tysecgh/woodreel/README.txt

木製スピニングリールの設計図のプロジェクト

designote.pdf
概要をまとめたテキスト

PARTS.pdf
部品ごとの平面図

scadfフォルダ以下
OpenScadによって記述したパラメトリック3Dモデル
それから生成した平面図(SVG)や可搬3Dモデル(STL)等

Licenses
- All files (including *.pdf, *.scad, *.tex, *.svg, *.stl): CC BY 4.0
  https://creativecommons.org/licenses/by/4.0/
Copyright (c) 2026 tysecgh
