tysecgh/woodreel/designote.pdf

# 木製スピニングリールの構造概要設計

平成 38 年 10 月 30 日

## 1 リール全体構造と部位 ID

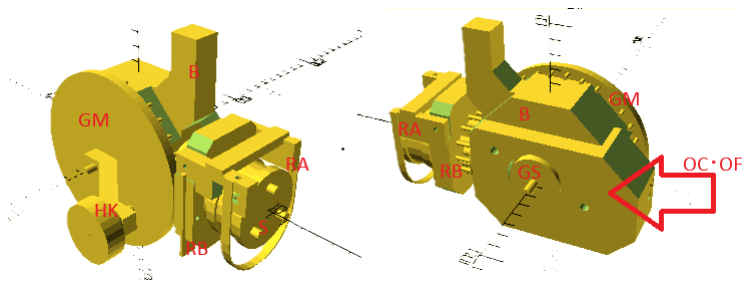
[picture p12: figure]

- [B] ボディ フット一体
- [S] スプール メインシャフトに沿って前後動, オシレーション機構に よって動く
- [R] ローター 前後積層構造 / メインシャフトを軸に回転 , ハンドル系 によって動く

– [RB] ローターボディ（ピンラックホイールと一体化してアームを 保持する, 重要部品の一つ. 前後積層構造）

– [RA] アーム（ローターボディ上で可動して糸の巻取り・放出を 切り替える部位）

– [RS] ストッパー（巻取り時アームを固定する部位）

- [M] メインシャフト スプールとローターをボディに保持
- [H] ハンドル系 力の入力と伝達, ローターとオシレーション機構を駆動

– [HK] ハンドル（実際回すところ，ハンドルシャフトに拘束）

– [HS] ハンドルシャフト

– [GM] メイン冠状歯車（ローターに回転を伝える部位, 歯の位置 精度は極めて重要, ハンドルに拘束）

1

– [GS] サブ冠状歯車（オシレーション機構に回転を伝える部位，ハ ンドルシャフトに拘束）

- [O] オシレーション機構 ハンドルから受けた回転を前後運動に変換し てスプールを駆動

– [OC] カム歯車（ハンドルシャフトから回転を受けるパーツとオ シレーション運動を生成するカムが一体になったもの）

– [OF] 受け子（カムから力を受けてオシレーションするパーツ, オ シレーションシャフトを拘束）

– [OS] オシレーションシャフト（オシレーション運動をスプールに 伝達するパーツ, 受け子とスプールに拘束）

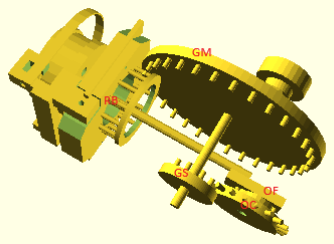
[picture p13: figure]

## 2 各パーツの局所的構成（ローカル詳細）

### [B] ボディ詳細

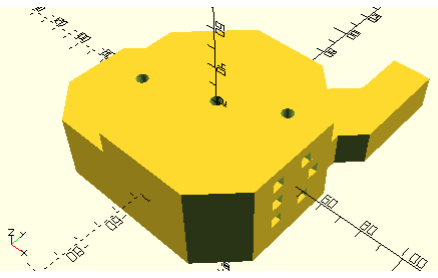
[picture p14: figure]

各動体機構の受け軸間の位置精度は最も重要 6 厚の板で左右積層構造. L3-1CR1-3 は固着して一体化. L4 層は分離可能に.

- [B-C] C 層（オシレーションシャフト, フット）
- [B-L1] L1 層（受け子, フット）
- [B-L2] L2 層（カム歯車カム部）
- [B-L3] L3 層（カム歯車歯車部、サブ冠状歯車歯部）

2

- [B-L4] L4 層（カム歯車軸受け、サブ冠状歯車基部、ハンドルシャフト 左側受け）この層のみ一体化せず開けるようにする事でオシレーション 機構にアクセスできるようにする
- [B-R1] R1 層（構造体, フット）
- [B-R2] R2 層（構造体）
- [B-R3] R3 層（構造体）ンドルシャフト右側受け, 現設計ではメイン ギアとの間に 3mm 分の隙間があり，ワッシャー的な間隔調整部品がが いる
- [B-F] フット部分

フット部分は複雑な機構は一切ないが単純に最も力がかかるという測面で 留意が必要. (魚との力というより人間が巻くときの力が最も大きい. ギア比 から言っても当然であるが)

### [M] メインシャフト詳細

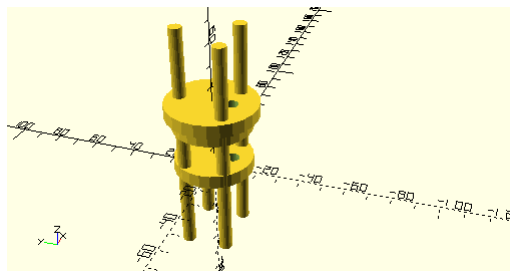
[picture p15: figure]

回転するローターの先でスプールが前後する機構上, 一種の中空構造が必 須となる. パイプ状は加工難度が高くなるため, ローターの (大) 円孔を内接 する多角形の頂点で保持する.
6 角形の頂点に軸を配置して大円を構成する構造、ただし 6 時方向軸はオ シレーションシャフトとの干渉を避けるためオミット. (理論上は三角形の頂 点で十分なので)
- [M-S0] S0 (長い, ローターとスプール保持)
- [M-S2] S2 (短い, ローター保持)
- [M-S4] S4 (長い, ローターとスプール保持)
- [M-S8] S8 (長い, ローターとスプール保持)
- [M-S10] S10 (短い, ローター保持)
- [M-Bb] Bb（シャフトをつなぐ橋構造ボディ側）

3

- [M-Bt0] Bt0（シャフトをつなぐ橋構造トップ側）
- [M-Bt1] Bt1（シャフトをつなぐ橋構造トップ側、ローターを保持）

### [R] ローター詳細

動機構が多く, また魚との間の力を直接受ける部位. その割にあまり大きく できないので最も難度の高い部位.

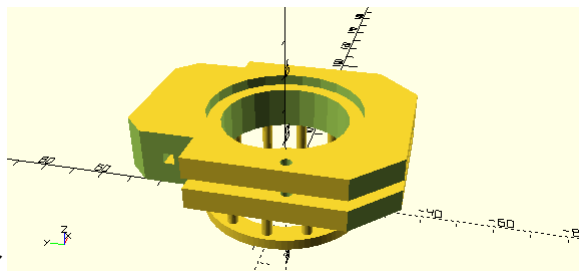
[picture p16: figure]

- [RB] ローターボディ
3 厚の板で前後積層構造.

– [RB-b] ピンラックホイールボディ側受け (ピンホイール精度は極 めて重要), メインシャフト大円 (この円精度は極めて重要)

– [RB-t0] ピンラックホイールトップ側受け, メインシャフト大円

– [RB-t1] ストッパー、アーム軸, メインシャフト大円

– [RB-t2] ストッパーとアーム軸の保持, メインシャフト大円、メ インシャフト保持部の受け

– [RB-t3] メインシャフト大円、メインシャフト保持部の受け

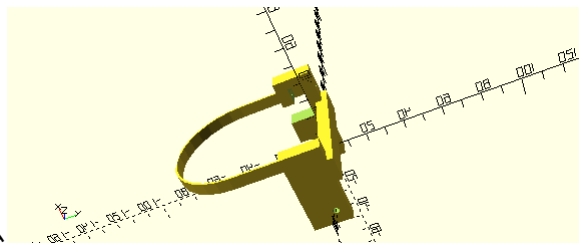
[picture p17: figure]

- [RA] アーム

魚との間の力を初めに受ける部位, その上可動部位で小さい. 可動のス ムーズさは使用感に大きく影響する. 使用感上, スムーズな巻取りとい うよりも糸と接触部の摩擦からの保護のためにラインローラー (もどき) は欲しい. 大きな力を受けたときに逃がす目的なのでローラー自体のス ムーズさはほとんどなくても役に立つ. 細部構造は設計図に反映しきっ てない (あまり他と干渉しないので後で作りこめる. そう木製ならね)

- [RS] ストッパー巻取り時にアームの可動を止める部位. 使用感に大き く影響する. 全木製にこだわった時のストッパーのバネは現物合わせで 竹をいい感じに削る以上のことが言えない

4

### [H] ハンドル系

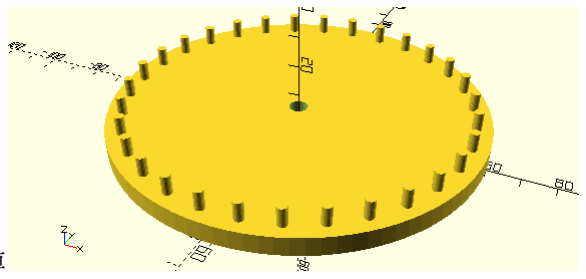
[picture p18: figure]

- [GM] メイン冠状歯車
（ローターに回転を伝える部位, 歯の位置精度は極めて重要, ハンドルに 拘束）

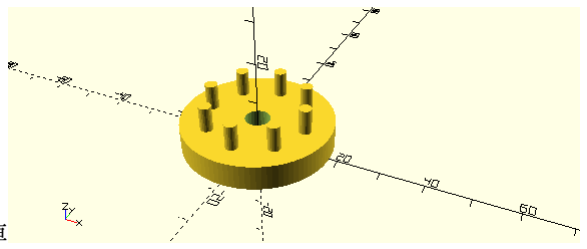
[picture p19: figure]

- [GS] サブ冠状歯車
（オシレーション機構に回転を伝える部位，ハンドルシャフトに拘束）

### [O] オシレーション機構詳細

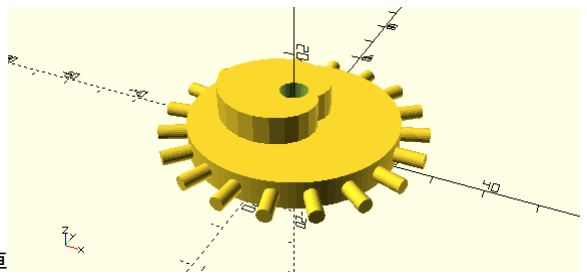
[picture p20: figure]

- [OC] カム歯車 | 小型
化は要求されるが, 魚との力は直接加わらない上に, 前後のカムの形状 精度もそれほど重要ではない. (実際問題ハートカムでなく単純な円状 カムでオシレーションを正弦波にしても使えなくはない)

– [OC-G] OC-G (歯車)

– [OC-C] OC-C (ハートカム)

5

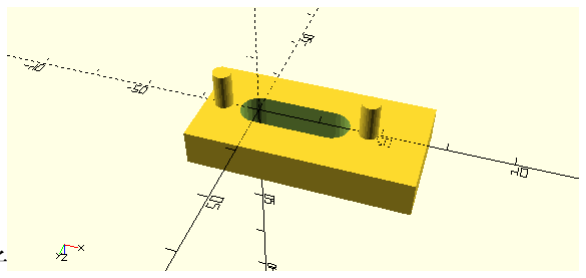
[picture p21: figure]

- [OF] 受け子 | （カム
から力を受けてオシレーションするパーツ, オシレーションシャフトを 拘束）
- [OS] オシレーションシャフト（オシレーション運動をスプールに伝達 するパーツ, 受け子とスプールに拘束）

### [S] スプール詳細

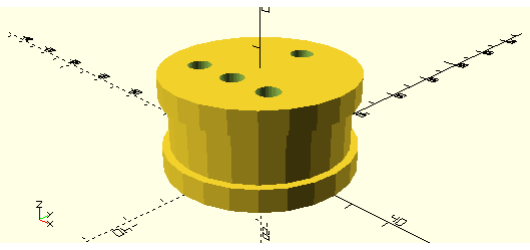
[picture p22: figure]

オシレーションの運動方向は魚とかかる力と直交しているので機構に直接 力がかかららない. また, 円形状は糸の放出のスムーズさにかかわるだけで巻 取り機構にはほぼ影響しない (何なら多角形でもあまり問題ない). という理 由から実は割と適当でいい部品.

## 3 機械機構設計

基体に穴をあけて竹串を指すという形式のピン歯車を基本とする. 形状精度や位置精度や剛性について手加工木製品であるという制限がある 中で, 求められる加工は正確な穴位置だけという破格の工作コストで機能す る機構を構成できる.
一方で工作精度の限界による軸ブレや素材の剛性によるしなり, 手加工故 の歯数の少なさから単純な直径比と歯数比以上に駆動被駆動を考慮した歯車 が必要となる.
既成の機械機構に比較にならないぐらいのガタツキが出るが, それでも工 作コストに対するコスパという点では著しいものがある.

6

### 巻取り系

ハンドル回転から直交する軸ローター回転. 最も力がかかる機構. 加速.
| [GM] 駆動 | [RB] 被駆動
形状 | 冠状ピン歯車 | ピンラックホイール
基準半径 | 55 mm | 21 mm
歯数 | 31 | 12
歯間直線距離 | 11.2 | 10.8
歯間直線距離について

駆動車の歯間直線距離 ≥ 被駆動車の歯間直線距離

ピン直径 × 2 ≤ 歯間直線距離

を満たさなければロックする. 一方で接触歯が次に移るタイミングでほぼ上 式差分空転する.

### オシレーション系

凡そ 6.1 巻きに一周期分オシレートする

オシレーション減速径

ハンドル回転から平行軸カム歯車回転. 減速.
| [GS] 駆動 | [OC] 被駆動
形状 | 冠状ピン歯車 | 放射状ピン歯車
基準半径 | 12 mm | - (軸間 √ 35² + 12² ≑ 37 mm )
歯数 | 8 | 19
歯間直線距離 | 9.2 | 8.2

オシレーション系

| [OC] 駆動 | [OF] 被駆動
形状 | 三角波一周期ハートカム | 両端押え
基準半径 | 6 mm — 18 mm

7
