tysecgh/woodreel/animation.gif

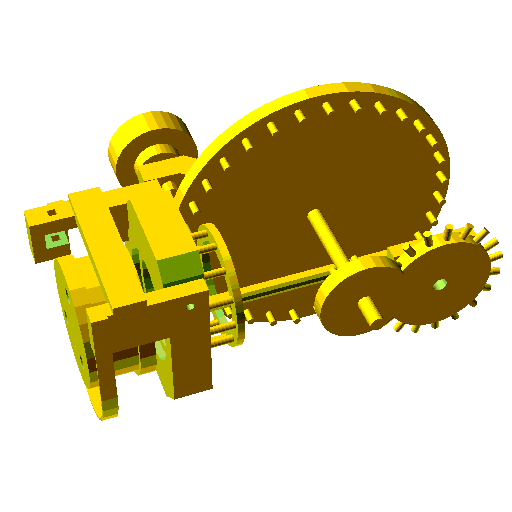
animation.gif
