tysecgh/woodreel/scad/VIEWS/frame_0000.png

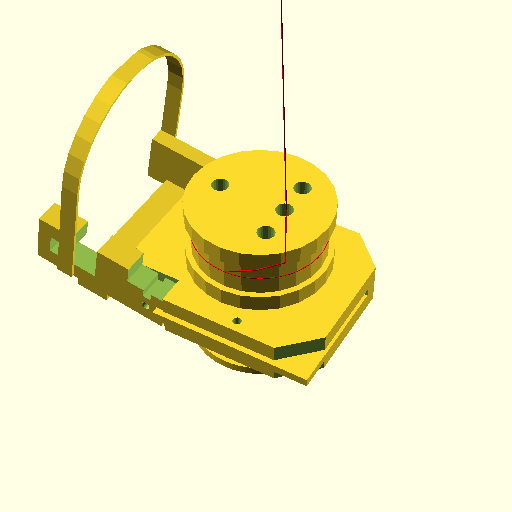
scad/VIEWS/frame_0000.png
