tysecgh/woodreel/scad/VIEWS/out.png

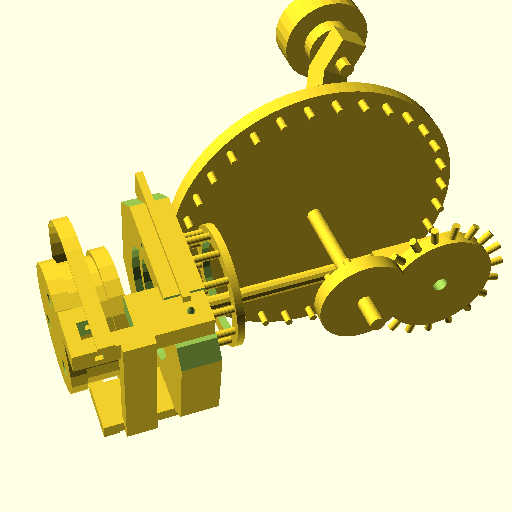
scad/VIEWS/out.png
