tysecgh/woodreel/text/fig/cstch.png

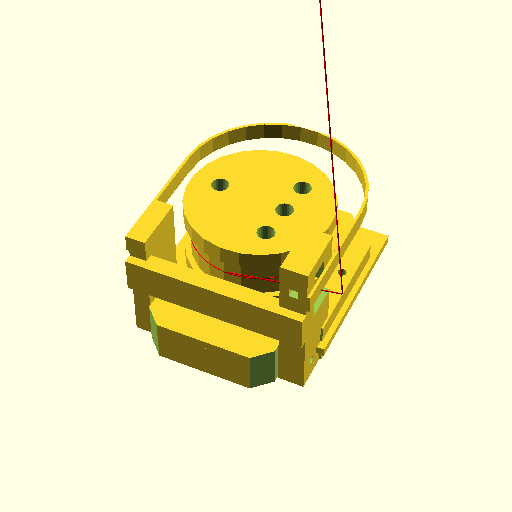
text/fig/cstch.png
