tysecgh/woodreel/text/fig/open.png

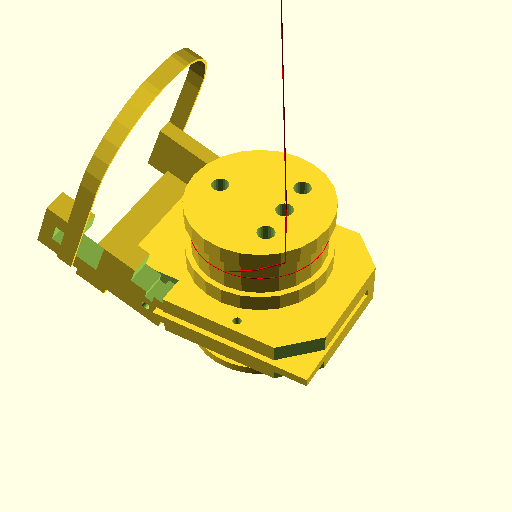
text/fig/open.png
