tysecgh/woodreel/text/fig/TOTAL0.png

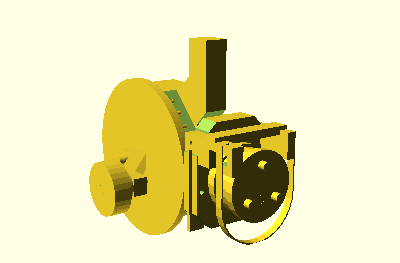
text/fig/TOTAL0.png
