tysecgh/woodreel/text/fig/TOTAL1.png

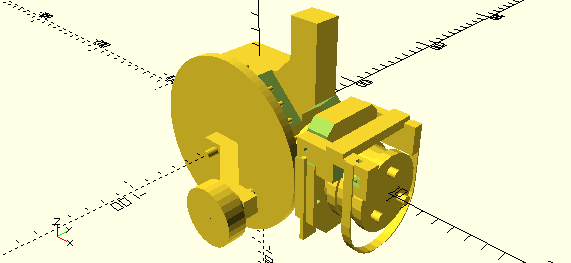
text/fig/TOTAL1.png
