tysecgh/woodreel/text/fig/TOTAL2.png

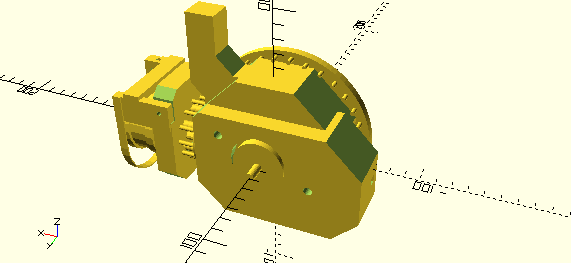
text/fig/TOTAL2.png
