tysecgh/woodreel/text/memo/OC/animationOC0.gif

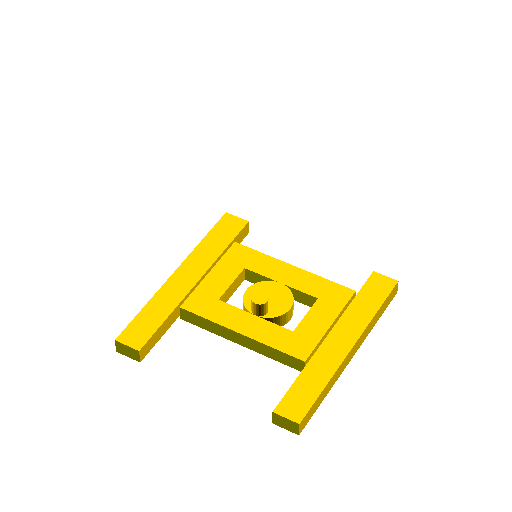
text/memo/OC/animationOC0.gif
