tysecgh/woodreel/text/memo/OC/animationOC2.gif

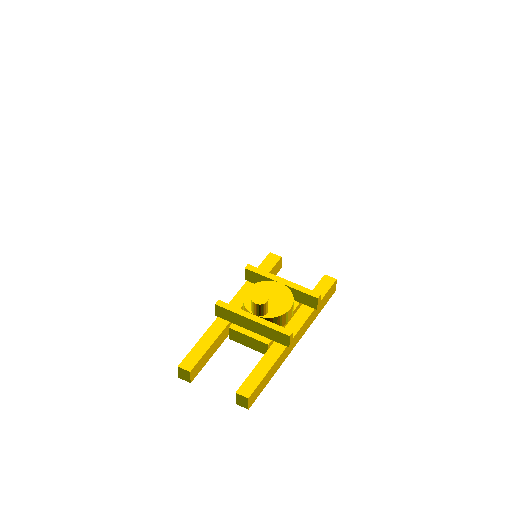
text/memo/OC/animationOC2.gif
