tysecgh/woodreel/PARTS.pdf

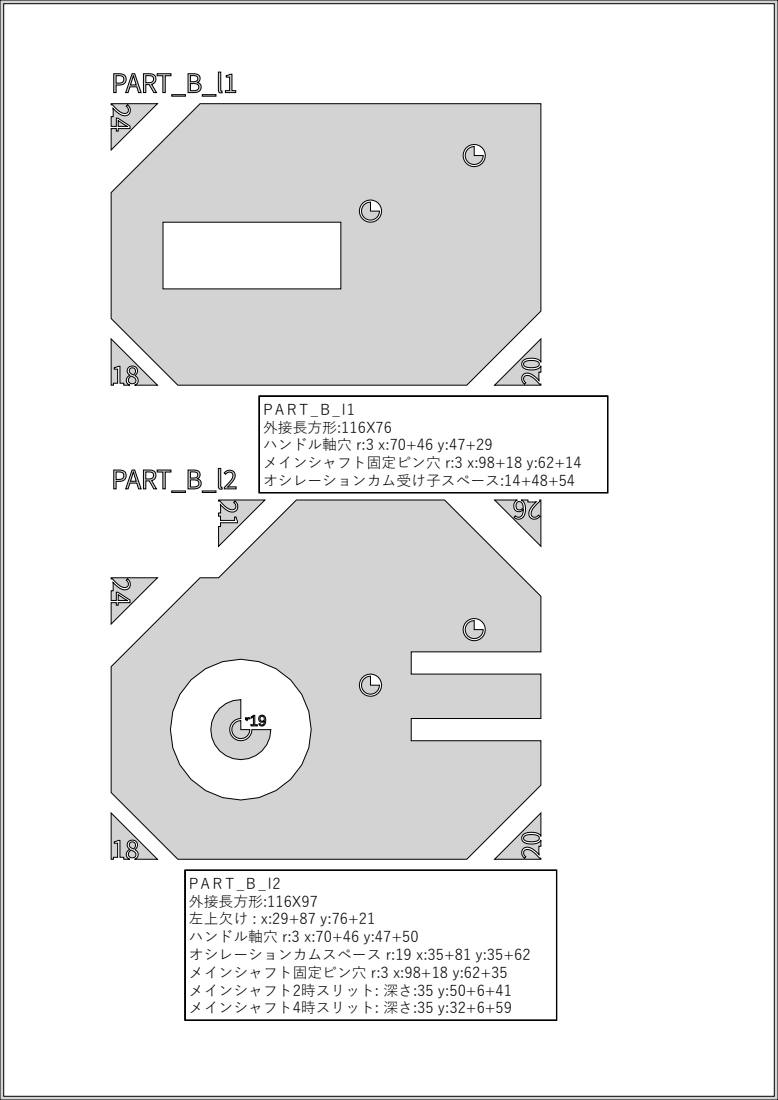
[picture p33: page 1]
PA R T _B _l1 外接長方形:116X76 ハンドル軸穴 r:3 x:70+46 y:47+29 メインシャフト固定ピン穴 r:3 x:98+18 y:62+14 オシレーションカム受け子スペース:14+48+54; PA R T _B _l2 外接長方形:116X97 左上欠け : x:29+87 y:76+21 ハンドル軸穴 r:3 x:70+46 y:47+50 オシレーションカムスペース r:19 x:35+81 y:35+62 メインシャフト固定ピン穴 r:3 x:98+18 y:62+35 メインシャフト2時スリット: 深さ:35 y:50+6+41 メインシャフト4時スリット: 深さ:35 y:32+6+59

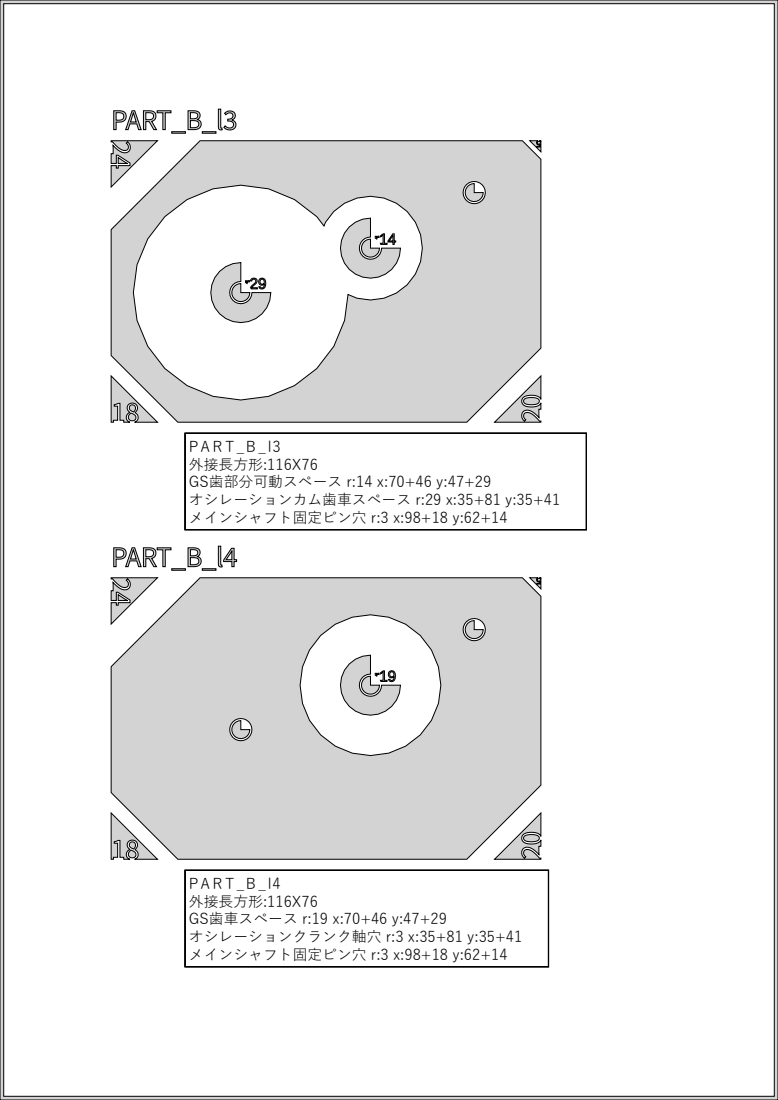
[picture p34: page 2]
PA R T _B _l3 外接長方形:116X76 GS歯部分可動スペース r:14 x:70+46 y:47+29 オシレーションカム歯車スペース r:29 x:35+81 y:35+41 メインシャフト固定ピン穴 r:3 x:98+18 y:62+14; PA R T _B _l4 外接長方形:116X76 GS歯車スペース r:19 x:70+46 y:47+29 オシレーションクランク軸穴 r:3 x:35+81 y:35+41 メインシャフト固定ピン穴 r:3 x:98+18 y:62+14

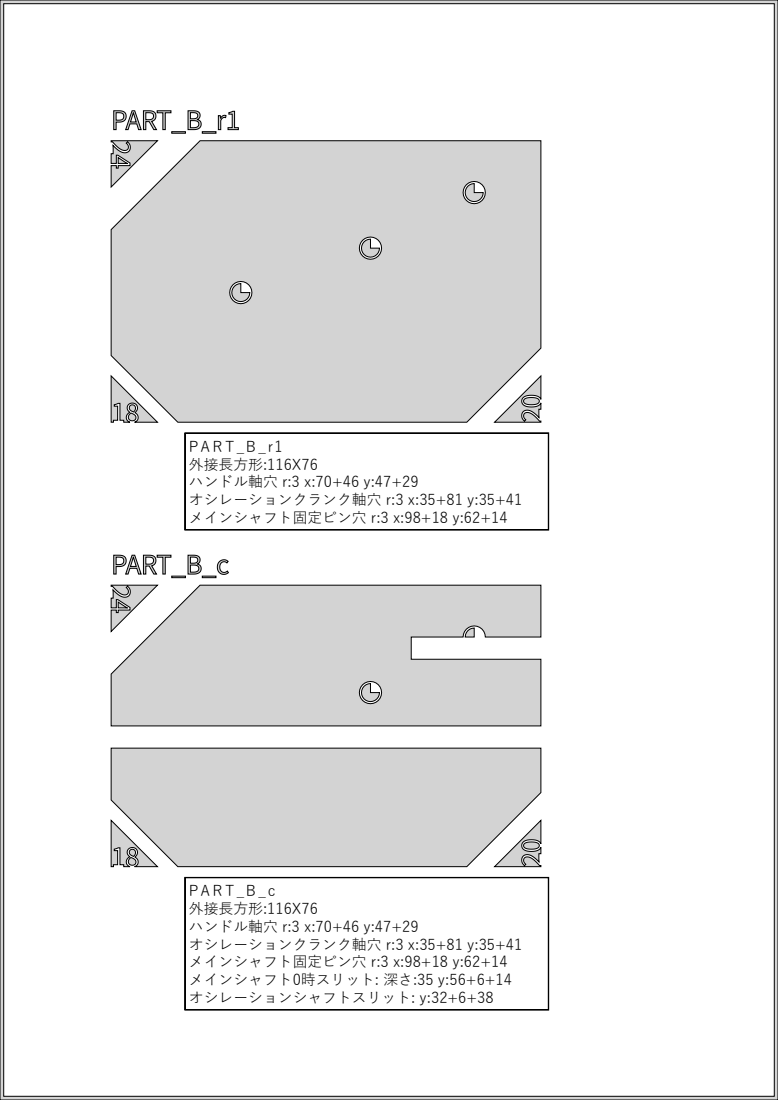
[picture p35: page 3]
PA R T _B _r1 外接長方形:116X76 ハンドル軸穴 r:3 x:70+46 y:47+29 オシレーションクランク軸穴 r:3 x:35+81 y:35+41 メインシャフト固定ピン穴 r:3 x:98+18 y:62+14; PA R T _B _c 外接長方形:116X76 ハンドル軸穴 r:3 x:70+46 y:47+29 オシレーションクランク軸穴 r:3 x:35+81 y:35+41 メインシャフト固定ピン穴 r:3 x:98+18 y:62+14 メインシャフト0時スリット: 深さ:35 y:56+6+14 オシレーションシャフトスリット: y:32+6+38

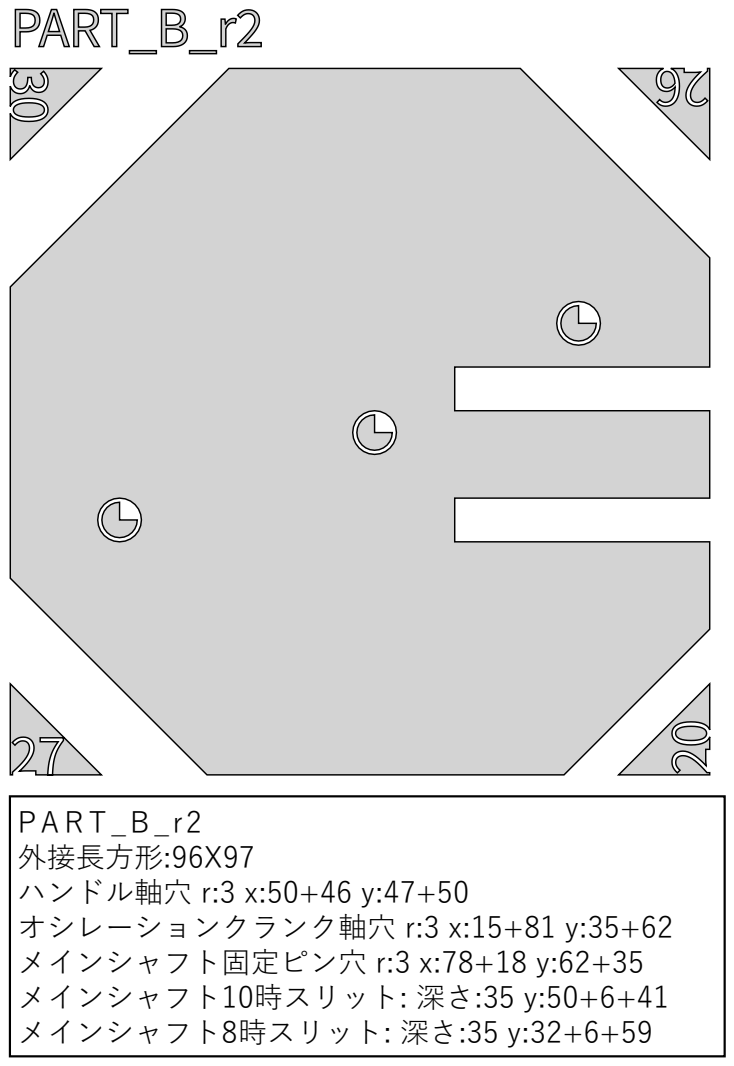
[picture p36: page 4]
PA R T _B _r2 外接長方形:96X97 ハンドル軸穴 r:3 x:50+46 y:47+50 オシレーションクランク軸穴 r:3 x:15+81 y:35+62 メインシャフト固定ピン穴 r:3 x:78+18 y:62+35 メインシャフト10時スリット: 深さ:35 y:50+6+41 メインシャフト8時スリット: 深さ:35 y:32+6+59

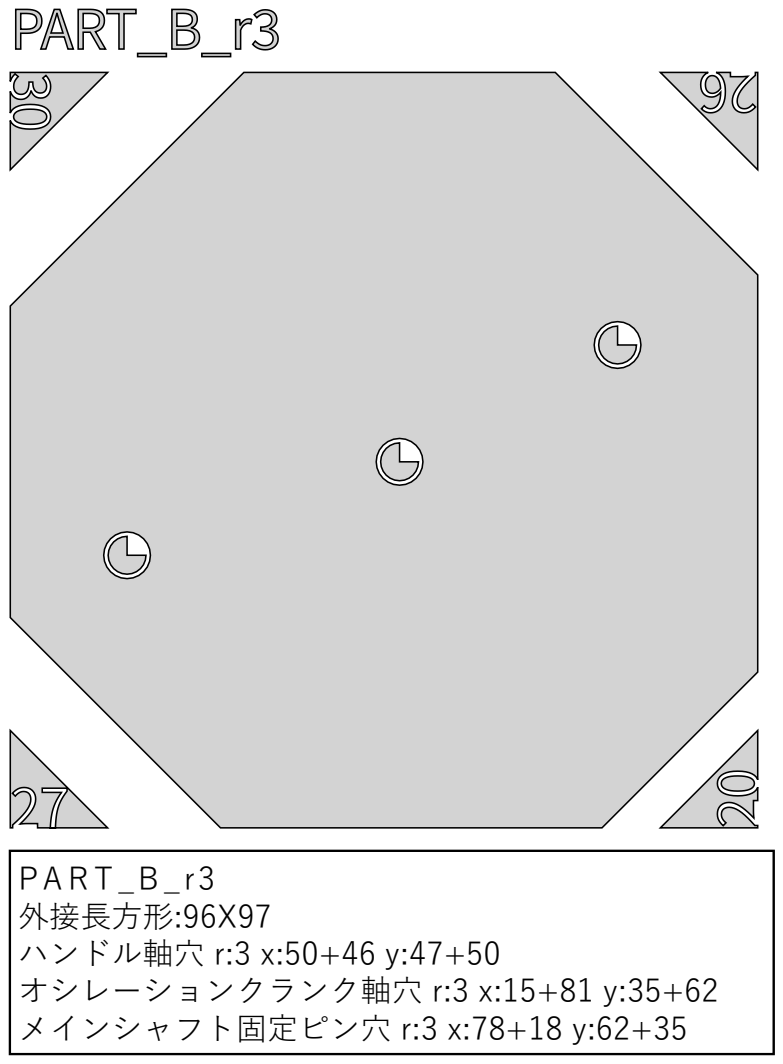
[picture p37: page 5]
PA R T _B _r3 外接長方形:96X97 ハンドル軸穴 r:3 x:50+46 y:47+50 オシレーションクランク軸穴 r:3 x:15+81 y:35+62 メインシャフト固定ピン穴 r:3 x:78+18 y:62+35

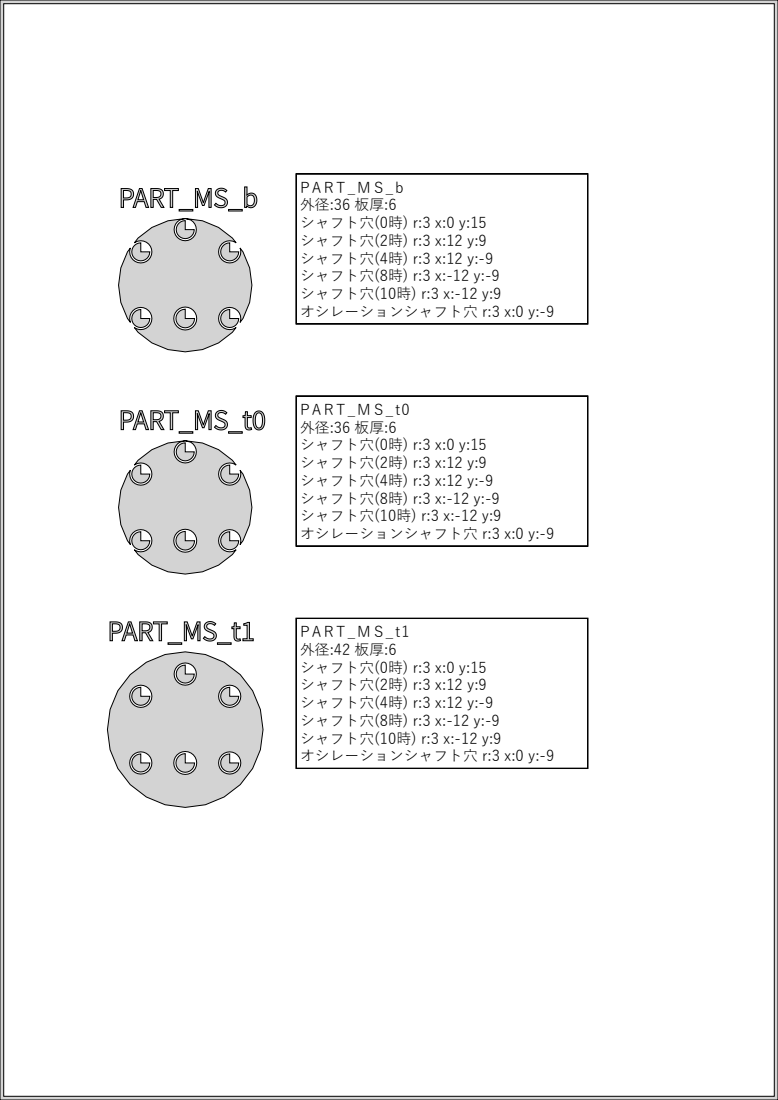
[picture p38: page 6]
PA R T _M S _b 外径:36 板厚:6 シャフト穴(0時) r:3 x:0 y:15 シャフト穴(2時) r:3 x:12 y:9 シャフト穴(4時) r:3 x:12 y:-9 シャフト穴(8時) r:3 x:-12 y:-9 シャフト穴(10時) r:3 x:-12 y:9 オシレーションシャフト穴 r:3 x:0 y:-9; PA R T _M S _t0 外径:36 板厚:6 シャフト穴(0時) r:3 x:0 y:15 シャフト穴(2時) r:3 x:12 y:9 シャフト穴(4時) r:3 x:12 y:-9 シャフト穴(8時) r:3 x:-12 y:-9 シャフト穴(10時) r:3 x:-12 y:9 オシレーションシャフト穴 r:3 x:0 y:-9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

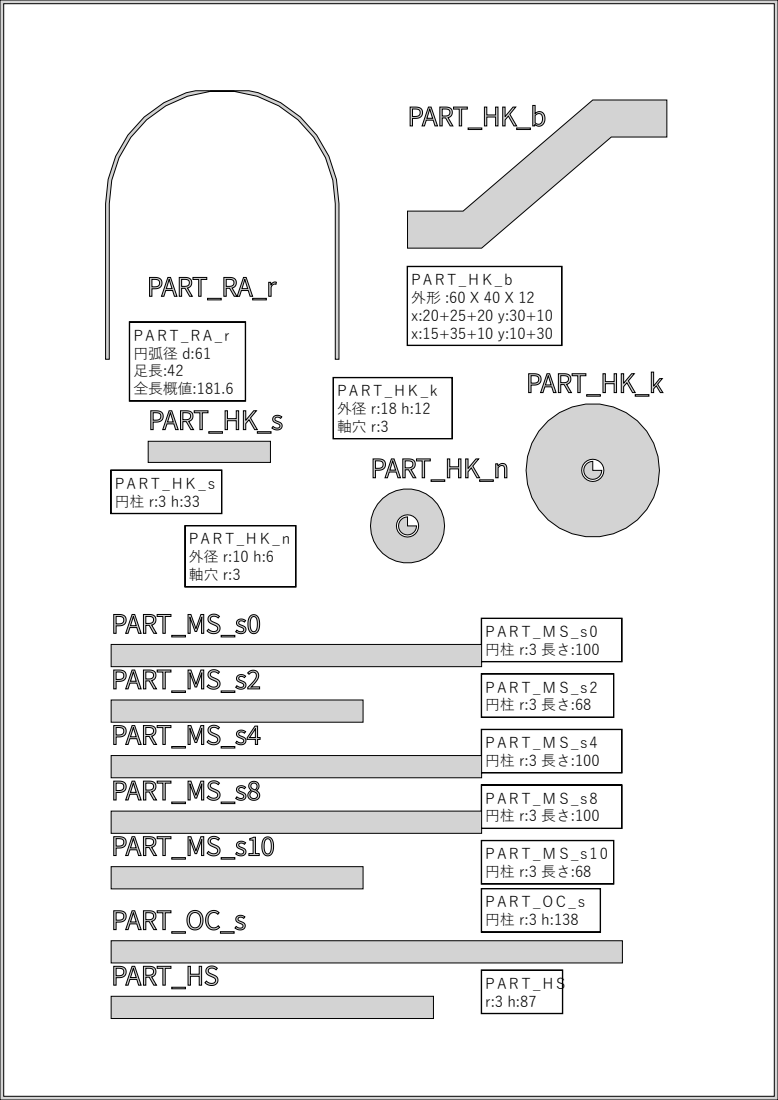
[picture p39: page 7]
PA R T _R A _r 円弧径 d:61 足長:42 全長概値:181.6

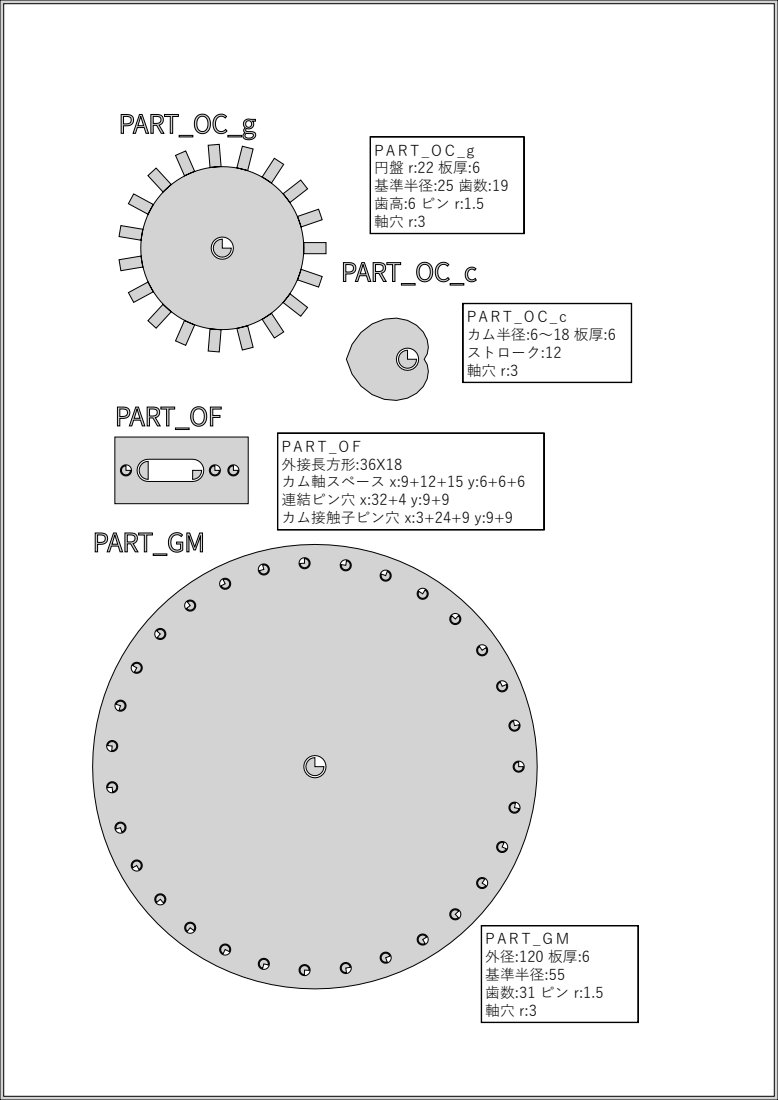
[picture p40: page 8]
PA R T _O C _g 円盤 r:22 板厚:6 基準半径:25 歯数:19 歯高:6 ピン r:1.5 軸穴 r:3; PA R T _O C _c カム半径:6〜18 板厚:6 ストローク:12 軸穴 r:3; PA R T _O F 外接長方形:36X18 カム軸スペース x:9+12+15 y:6+6+6 連結ピン穴 x:32+4 y:9+9 カム接触子ピン穴 x:3+24+9 y:9+9; PA R T _G M 外径:120 板厚:6 基準半径:55 歯数:31 ピン r:1.5 軸穴 r:3

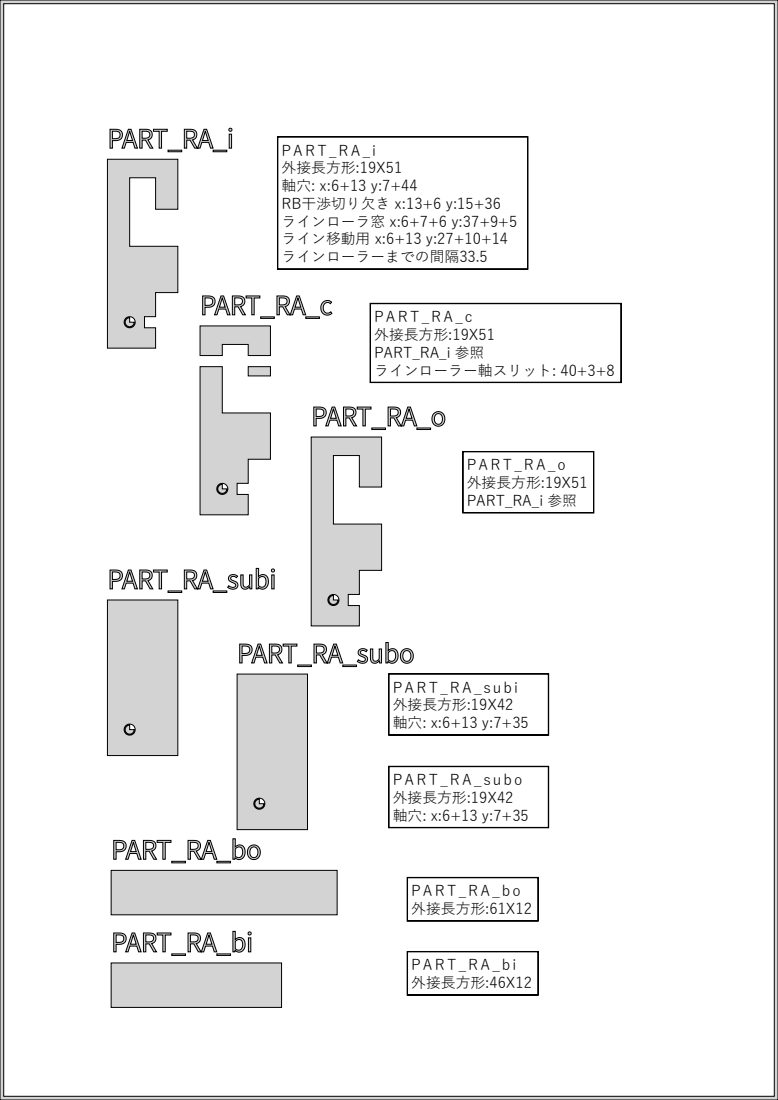
[picture p41: page 9]
PA R T _R A _i 外接長方形:19X51 軸穴: x:6+13 y:7+44 RB干渉切り欠き x:13+6 y:15+36 ラインローラ窓 x:6+7+6 y:37+9+5 ライン移動用 x:6+13 y:27+10+14 ラインローラーまでの間隔33.5; PA R T _R A _c 外接長方形:19X51 PART_RA_i 参照 ラインローラー軸スリット: 40+3+8; PA R T _R A _o 外接長方形:19X51 PART_RA_i 参照; PA R T _R A _su b i 外接長方形:19X42 軸穴: x:6+13 y:7+35; PA R T _R A _su b o 外接長方形:19X42 軸穴: x:6+13 y:7+35; PA R T _R A _b o 外接長方形:61X12; PA R T _R A _b i 外接長方形:46X12

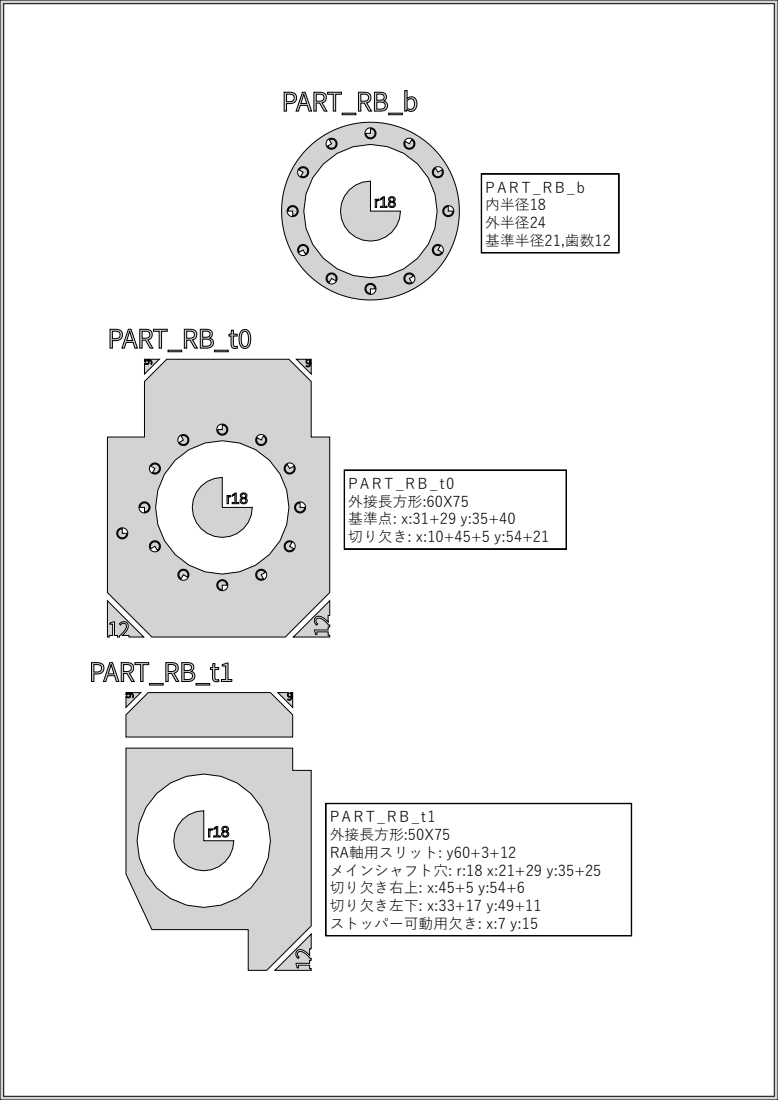
[picture p42: page 10]
PA R T _R B _b 内半径18 外半径24 基準半径21,歯数12; PA R T _R B _t0 外接長方形:60X75 基準点: x:31+29 y:35+40 切り欠き: x:10+45+5 y:54+21; PA R T _R B _t1 外接長方形:50X75 RA軸用スリット: y60+3+12 メインシャフト穴: r:18 x:21+29 y:35+25 切り欠き右上: x:45+5 y:54+6 切り欠き左下: x:33+17 y:49+11 ストッパー可動用欠き: x:7 y:15

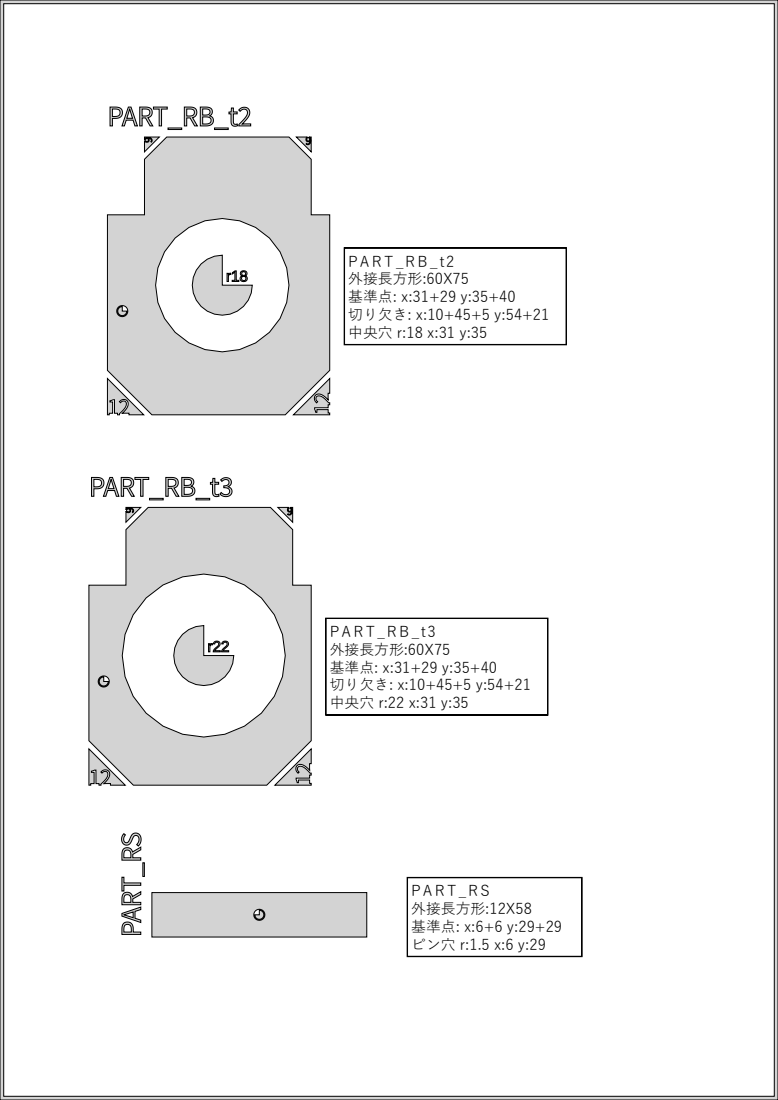
[picture p43: page 11]
PA R T _R B _t2 外接長方形:60X75 基準点: x:31+29 y:35+40 切り欠き: x:10+45+5 y:54+21 中央穴 r:18 x:31 y:35; PA R T _R B _t3 外接長方形:60X75 基準点: x:31+29 y:35+40 切り欠き: x:10+45+5 y:54+21 中央穴 r:22 x:31 y:35; PA R T _R S 外接長方形:12X58 基準点: x:6+6 y:29+29 ピン穴 r:1.5 x:6 y:29

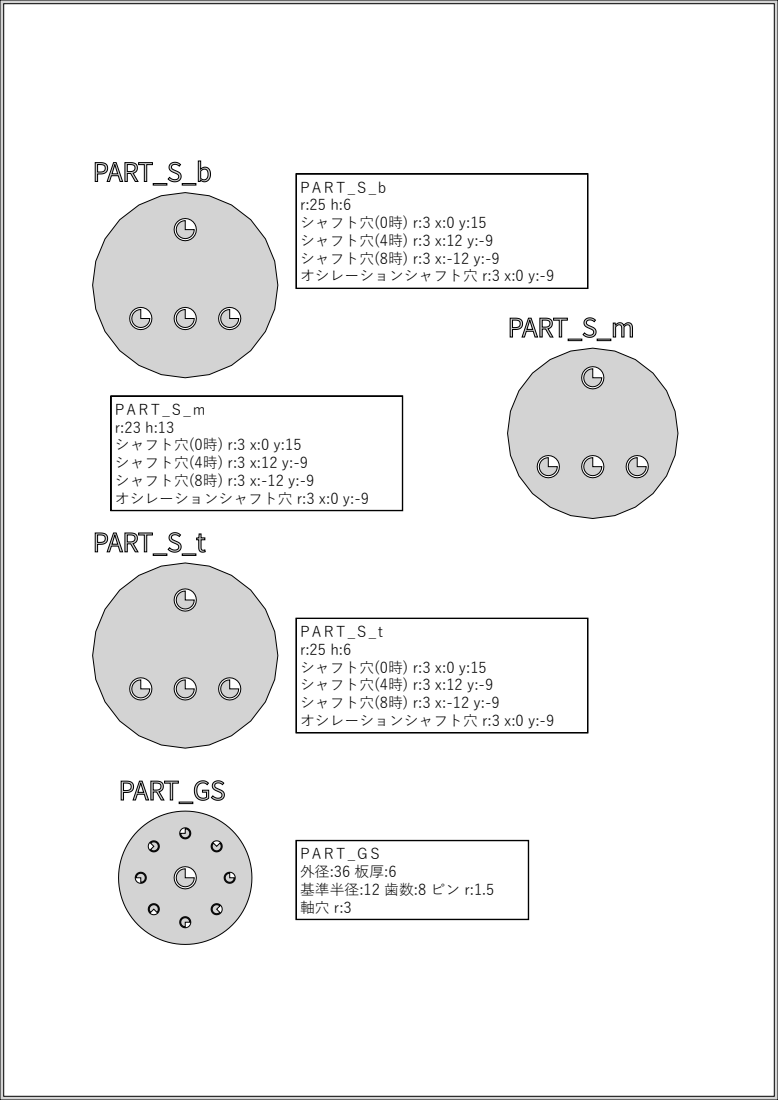
[picture p44: page 12]
PA R T _S _b r:25 h:6 シャフト穴(0時) r:3 x:0 y:15 シャフト穴(4時) r:3 x:12 y:-9 シャフト穴(8時) r:3 x:-12 y:-9 オシレーションシャフト穴 r:3 x:0 y:-9; PA R T _S _m r:23 h:13 シャフト穴(0時) r:3 x:0 y:15 シャフト穴(4時) r:3 x:12 y:-9 シャフト穴(8時) r:3 x:-12 y:-9 オシレーションシャフト穴 r:3 x:0 y:-9; PA R T _S _t r:25 h:6 シャフト穴(0時) r:3 x:0 y:15 シャフト穴(4時) r:3 x:12 y:-9 シャフト穴(8時) r:3 x:-12 y:-9 オシレーションシャフト穴 r:3 x:0 y:-9

基準半径:12 歯数:8 ピン r:1.5
