tysecgh/woodreel/scad/VIEWS/STL/TOTAL.stl

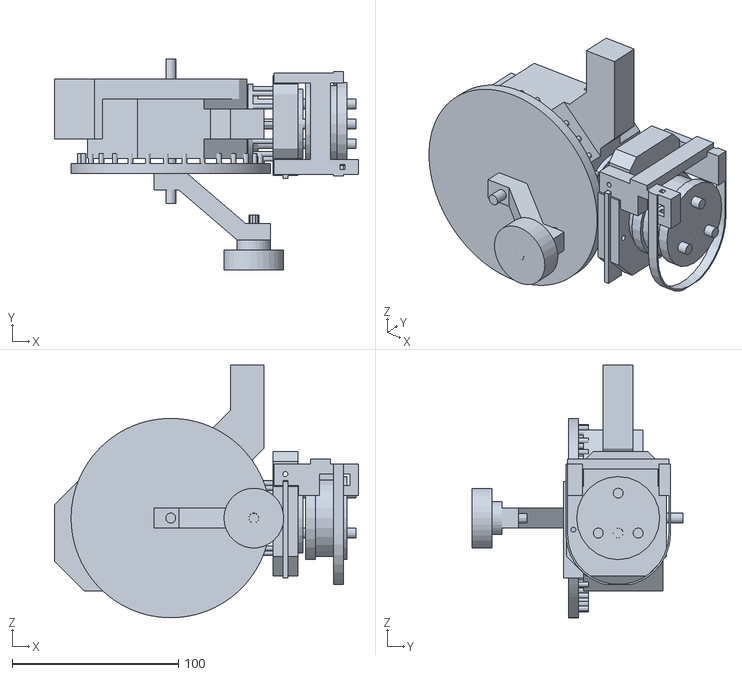
[picture p45: CAD file, 2026-10-30]
scad/VIEWS/STL/TOTAL.stl
183.0 x 127.0 x 152.0
