tysecgh/woodreel/scad/ASSYS/STL/B.stl

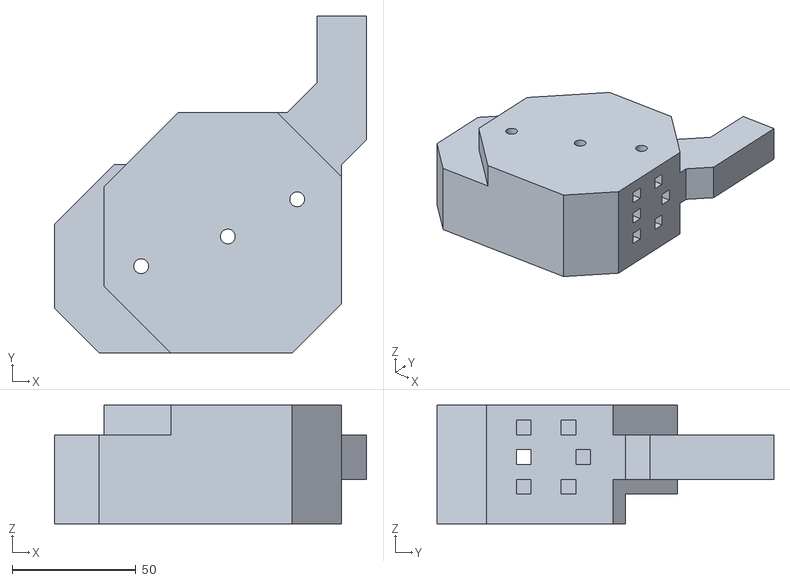
[picture p46: CAD file, 2026-10-30]
scad/ASSYS/STL/B.stl
126.0 x 136.0 x 48.0
