tysecgh/woodreel/scad/ASSYS/STL/OC.stl

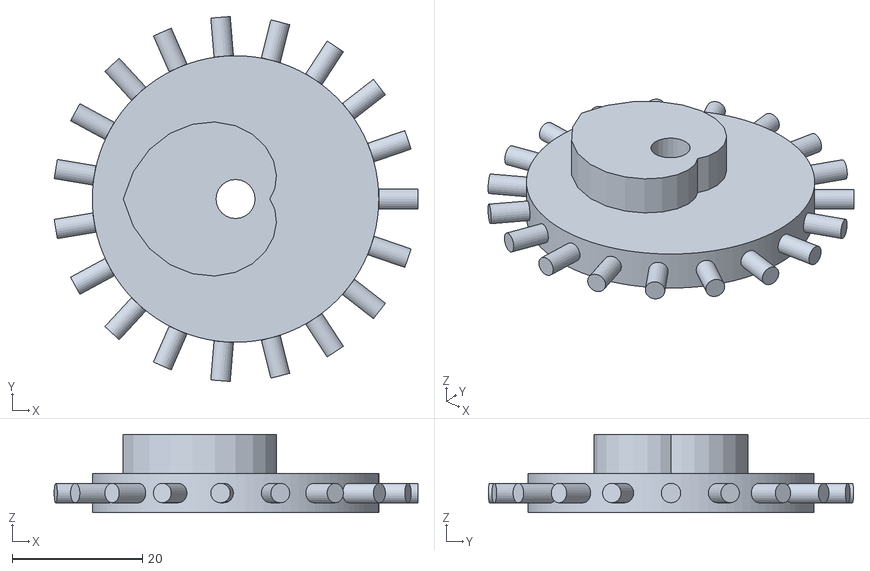
[picture p47: CAD file, 2026-10-30]
scad/ASSYS/STL/OC.stl
55.9 x 56.1 x 12.0
