tysecgh/woodreel/scad/ASSYS/STL/RA.stl

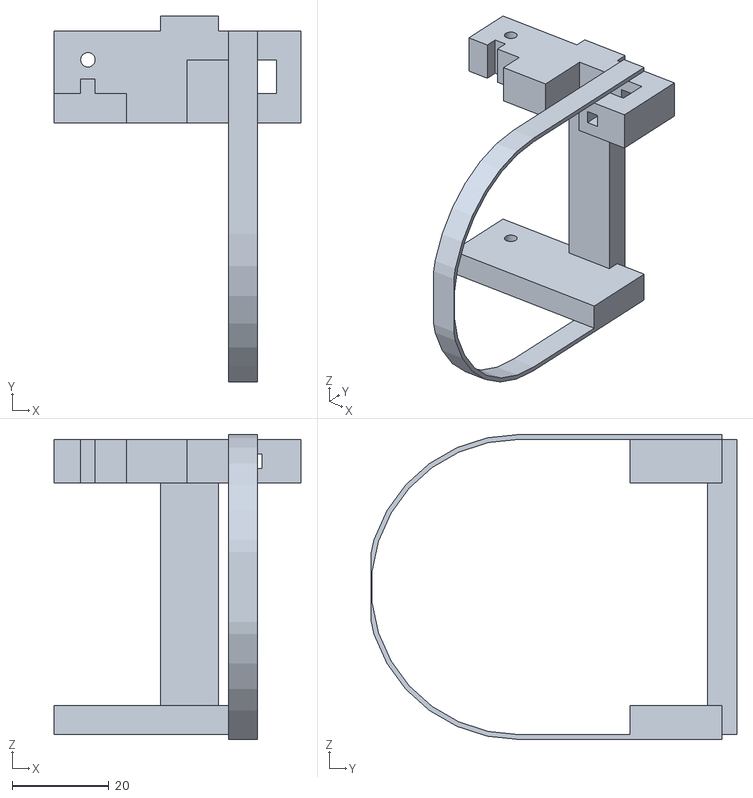
[picture p48: CAD file, 2026-10-30]
scad/ASSYS/STL/RA.stl
51.0 x 75.5 x 63.0
