tysecgh/woodreel/scad/ASSYS/STL/MS.stl

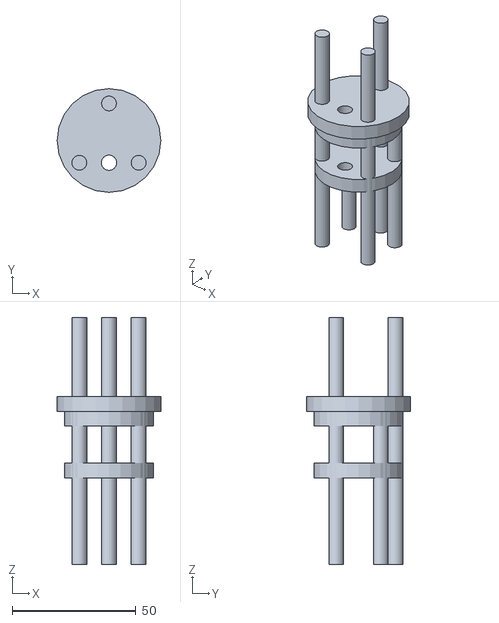
[picture p49: CAD file, 2026-10-30]
scad/ASSYS/STL/MS.stl
42.0 x 42.0 x 100.0
