tysecgh/woodreel/scad/ASSYS/STL/GM.stl

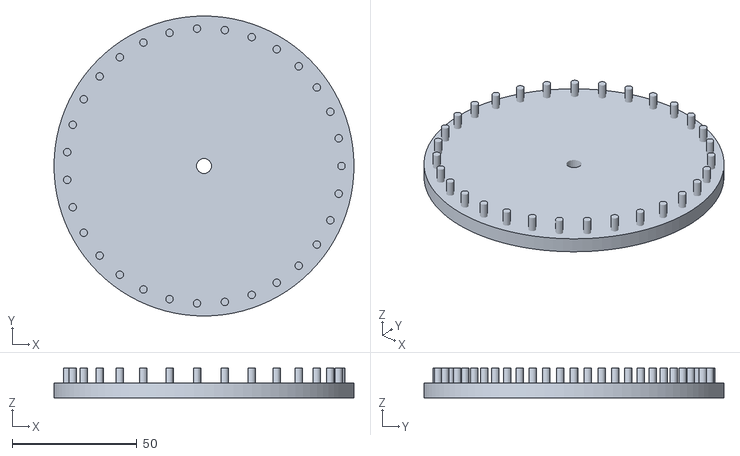
[picture p50: CAD file, 2026-10-30]
scad/ASSYS/STL/GM.stl
120.0 x 120.0 x 12.0
