tysecgh/woodreel/scad/ASSYS/STL/GS.stl

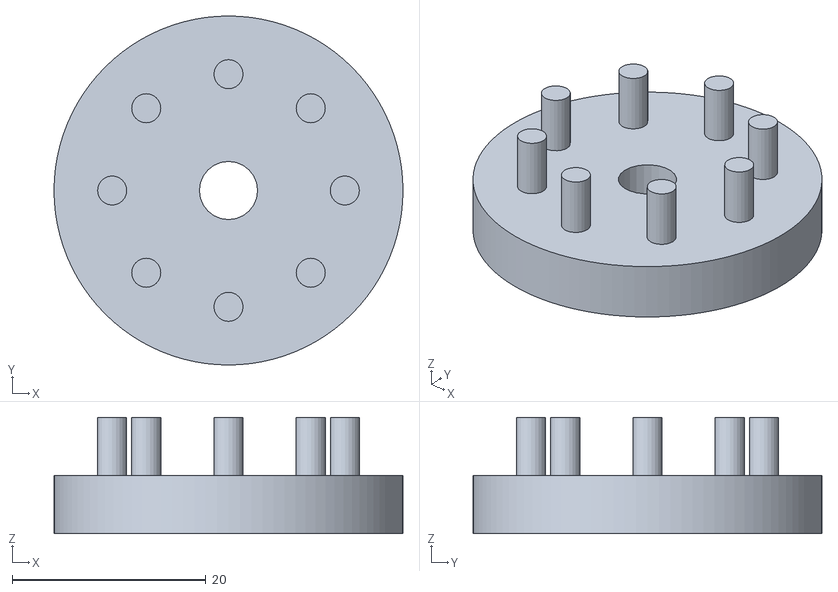
[picture p51: CAD file, 2026-10-30]
scad/ASSYS/STL/GS.stl
36.0 x 36.0 x 12.0
