tysecgh/woodreel/scad/ASSYS/STL/RB.stl

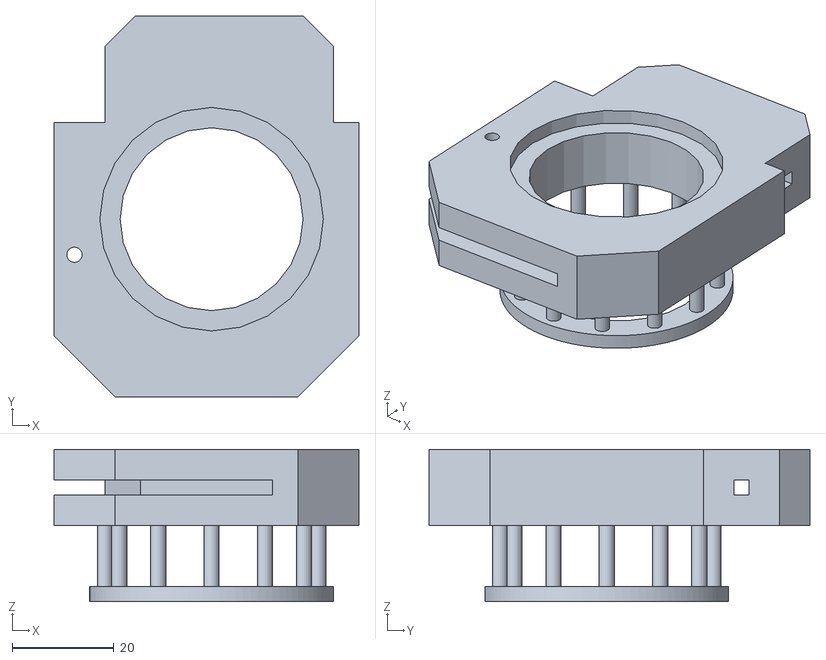
[picture p52: CAD file, 2026-10-30]
scad/ASSYS/STL/RB.stl
60.0 x 75.0 x 30.0
