tysecgh/woodreel/scad/ASSYS/STL/S.stl

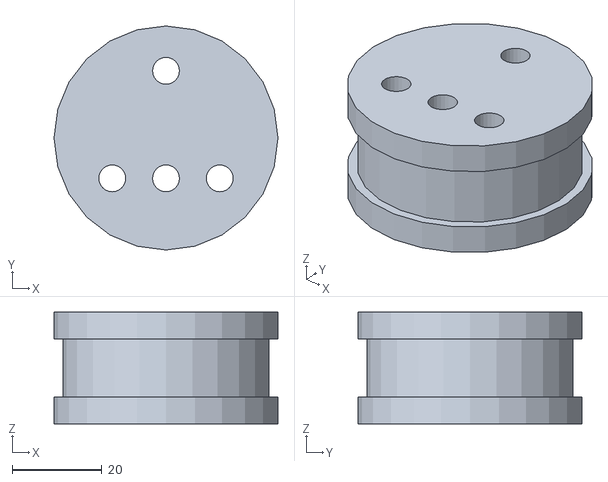
[picture p53: CAD file, 2026-10-30]
scad/ASSYS/STL/S.stl
50.0 x 50.0 x 25.0
