tysecgh/woodreel/scad/ASSYS/STL/OF.stl

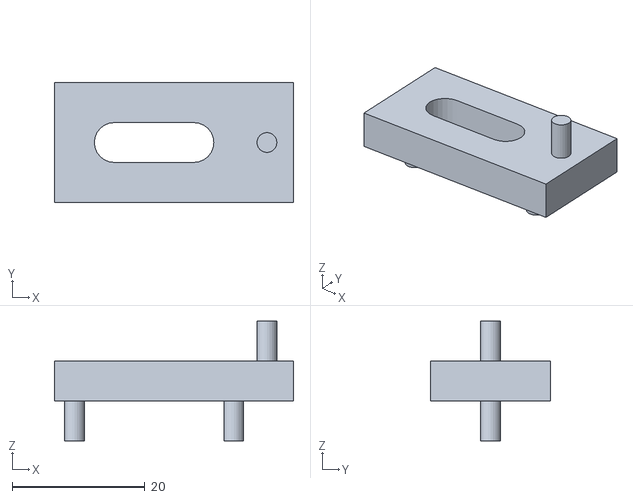
[picture p54: CAD file, 2026-10-30]
scad/ASSYS/STL/OF.stl
36.0 x 18.0 x 18.0
