tysecgh/woodreel/scad/ASSYS/B.scad

include <../main.scad>
$holeflg = false;
$chamfflg = false;

ASSY_B();
