tysecgh/woodreel/scad/ASSYS/GM.scad

include <../main.scad>
$holeflg = false;
$chamfflg = false;

UNIT_GM();
