tysecgh/woodreel/scad/ASSYS/GS.scad

include <../main.scad>
$holeflg = false;
$chamfflg = false;

UNIT_GS();
