tysecgh/woodreel/scad/ASSYS/MS.scad

include <../main.scad>
$holeflg = false;
$chamfflg = false;

ASSY_MS();
