tysecgh/woodreel/scad/ASSYS/OC.scad

include <../main.scad>
$holeflg = false;
$chamfflg = false;

ASSY_OC();
