tysecgh/woodreel/scad/ASSYS/OF.scad

include <../main.scad>
$holeflg = false;
$chamfflg = false;

UNIT_OF();
