tysecgh/woodreel/scad/ASSYS/RA.scad

include <../main.scad>
$holeflg = false;
$chamfflg = false;

ASSY_RA();
