tysecgh/woodreel/scad/ASSYS/RB.scad

include <../main.scad>
$holeflg = false;
$chamfflg = false;

ASSY_RB();
