tysecgh/woodreel/scad/ASSYS/S.scad

include <../main.scad>
$holeflg = false;
$chamfflg = false;

UNIT_S();
