tysecgh/woodreel/scad/PARTS/_empty.scad

include <../main.scad>
include <../lib/svgtxt.scad>
include <../lib/scale.scad>
$nameflg = true;

$prjflg = false; // 調整時 false にしておくとpreviewが軽い
module switch_proj() {
    if ($prjflg) projection() children();
    else children();
}













// A4外枠 & 余白マーカー
difference(){ 
    w = 210; h = 297; 
    d = $prjflg ? 1 : 20 ;
    square([w,h]); translate([d,d]) square([w-2*d,h-2*d]); 
}
// これが実寸に会うと縮小されてない
scale([20,15,0]);

///////////////////////////////
///////////////////////////////

basex = 0; basey = 0;

union(){
    x = 0+basex; y =0+basey;     
    switch_proj()
    translate([x,y,0]){}


    svgtxt( ["TITLE","comment1","comment2"], [x+100,y+100] );
}
