tysecgh/woodreel/scad/VIEWS/TOTAL.scad

include <../main.scad>

$holeflg = false;
$chamfflg = false;

$time = 0;

VIEW_TOTAL($time);
