tysecgh/woodreel/text/memo/OC/OC0.scad

$time = 30;

h=6;
cr = 9;
mr = 6;
fw = 10;


module OF(){
    translate([-fw-(cr-mr),-(cr+mr),0])cube([fw,(cr+mr)*2,h]);
    translate([(cr+mr),-(cr+mr),0])cube([fw,(cr+mr)*2,h]);
    translate([-fw-(cr-mr),-3-fw,-h])cube([fw*2+cr*2,fw,h]);
    translate([-fw-(cr-mr),3,-h])cube([fw*2+cr*2,fw,h]);
}
    


module OC(){
    translate([0,0,-h])cylinder(r=3,h=h*3,$fn=64);
    translate([mr,0,0])cylinder(r=cr,h=h,$fn=64);
}

translate([-fw-(cr-mr)-mr*4,3+fw+1,0])cube([fw*2+cr*2+mr*6,fw,h]);
translate([-fw-(cr-mr)-mr*4,-3-2*fw-1,0])cube([fw*2+cr*2+mr*6,fw,h]);

translate([mr*(cos($time)-1),0,0])OF();
rotate([0,0,$time])OC();
