tysecgh/woodreel/(list of files, cad)

Other CAD files:
scad/main.scad
scad/PARTS/BL1.scad
scad/PARTS/BL3.scad
scad/PARTS/BR1.scad
scad/PARTS/BR2.scad
scad/PARTS/BR3.scad
scad/PARTS/MS.scad
scad/PARTS/OC.scad
scad/PARTS/RB_1.scad
scad/PARTS/RB_2.scad
scad/PARTS/S.scad
text/memo/OC/OC2.scad
text/memo/OC/OC3.scad
