tysecgh/woodreel/scad/tool/gifanime_mainthread_fixed2.html

# PNG to GIF Studio

連番画像から高画質GIFアニメーションをローカルで一括生成

完全ローカル処理（サーバー送信なし）

ここにPNGファイルをドラッグ＆ドロップ

またはクリックしてファイルを選択（複数選択対応）

## プレビュー

0 / 0 フレーム

PNG画像を読み込むとここにプレビューが表示されます

再生

解像度: 未設定

## アニメーション設定

フレームレート (FPS) 10 FPS

1秒あたりのコマ数 (標準: 8?12 FPS)

品質 (カラーサンプル)

数値が小さいほど色精度が高くなります

出力サイズ調整

W:

H:

空欄の場合は元画像の解像度を維持します

無限ループ再生 背景の透明度を維持 (透過PNG用)

GIFアニメーションを生成

## フレーム一覧 0

名前順 クリア

ドラッグ＆ドロップでフレームの順序を自由に並び替えることができます。

画像を読み込むとフレームがここに配置されます

### GIF生成中...

フレームを読み込んでレンダリングを行っています

### GIFアニメの生成が完了しました！

下記から生成されたGIFの保存・プレビューが可能です

ファイルサイズ: 0 MB

閉じる 保存する
